GraysonKippes/stm32g071-devkit/kicad/stm32g0-devkit.kicad_pcb

## KiCad design kicad/stm32g0-devkit.kicad_pcb (2026-10-22)

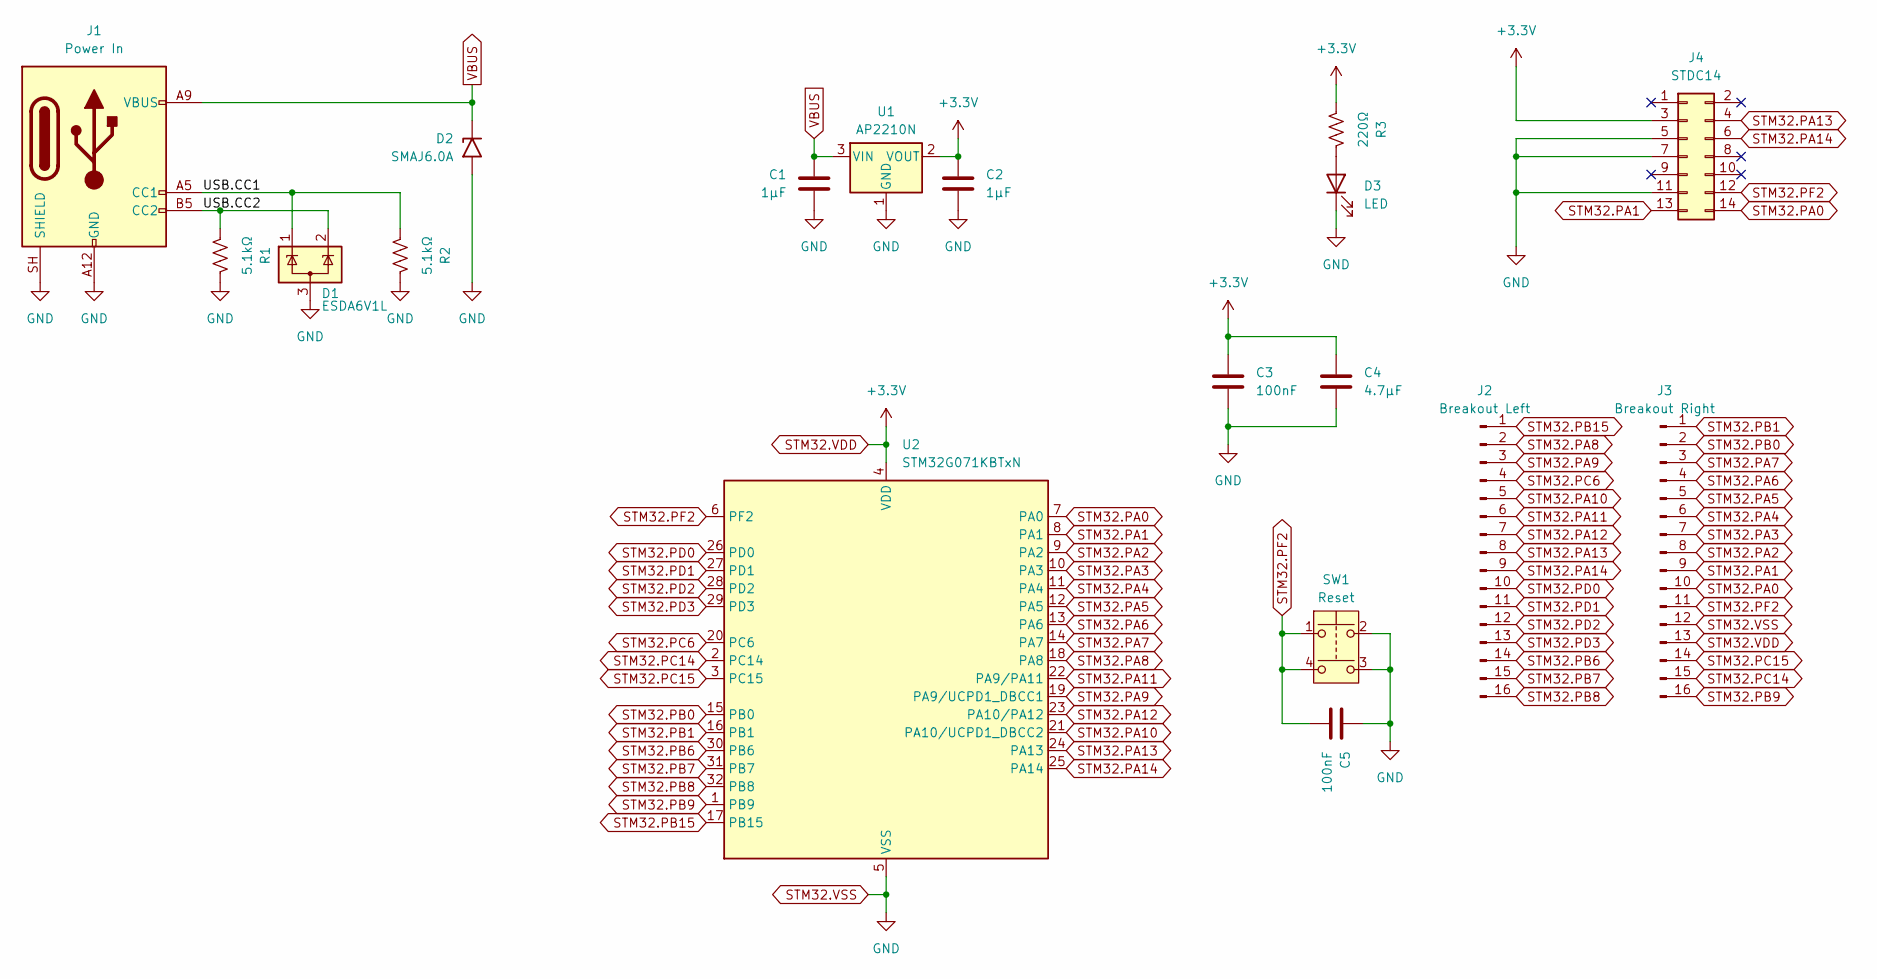
[picture p1: schematic stm32g0-devkit.kicad_sch]

Parts:
C1, C2: 1μF; C_0805_2012Metric_Pad1.18x1.45mm_HandSolder
C3, C5: 100nF; C_0805_2012Metric_Pad1.18x1.45mm_HandSolder
C4: 4.7μF; C_0805_2012Metric_Pad1.18x1.45mm_HandSolder
D1: ESDA6V1L; SOT-23
D2: SMAJ6.0A; D_SMA_Handsoldering
D3: LED; LED_0805_2012Metric_Pad1.15x1.40mm_HandSolder
J1: Power In; USB_C_Receptacle_GCT_USB4135-GF-A_6P_TopMnt_Horizontal
J2: Breakout Left; PinSocket_1x16_P2.54mm_Vertical
J3: Breakout Right; PinSocket_1x16_P2.54mm_Vertical
J4: STDC14; PinSocket_2x07_P1.27mm_Vertical
R1, R2: 5.1kΩ; R_0805_2012Metric_Pad1.20x1.40mm_HandSolder
R3: 220Ω; R_0805_2012Metric_Pad1.20x1.40mm_HandSolder
SW1: Reset; KMR221NG
U1: AP2210N; SOT-23-3
U2: STM32G071KBTxN; LQFP-32_7x7mm_P0.8mm

Connections:
/USB.CC1: D1.1 (K), J1.A5 (CC1), R2.1
/USB.CC2: D1.2 (K), J1.B5 (CC2), R1.1
unnamed: D3.2 (A), R3.2
STM32.PA0: J3.10, J4.14, U2.7 (PA0)
STM32.PA1: J3.9, J4.13, U2.8 (PA1)
STM32.PA2: J3.8, U2.9 (PA2)
STM32.PA3: J3.7, U2.10 (PA3)
STM32.PA4: J3.6, U2.11 (PA4)
STM32.PA5: J3.5, U2.12 (PA5)
STM32.PA6: J3.4, U2.13 (PA6)
STM32.PA7: J3.3, U2.14 (PA7)
STM32.PA8: J2.2, U2.18 (PA8)
STM32.PA9: J2.3, U2.19 (PA9/UCPD1_DBCC1)
STM32.PA10: J2.5, U2.21 (PA10/UCPD1_DBCC2)
STM32.PA11: J2.6, U2.22 (PA9/PA11)
STM32.PA12: J2.7, U2.23 (PA10/PA12)
STM32.PA13: J2.8, J4.4, U2.24 (PA13)
STM32.PA14: J2.9, J4.6, U2.25 (PA14)
STM32.PB0: J3.2, U2.15 (PB0)
STM32.PB1: J3.1, U2.16 (PB1)
STM32.PB6: J2.14, U2.30 (PB6)
STM32.PB7: J2.15, U2.31 (PB7)
STM32.PB8: J2.16, U2.32 (PB8)
STM32.PB9: J3.16, U2.1 (PB9)
STM32.PB15: J2.1, U2.17 (PB15)
STM32.PC6: J2.4, U2.20 (PC6)
STM32.PC14: J3.15, U2.2 (PC14)
STM32.PC15: J3.14, U2.3 (PC15)
STM32.PD0: J2.10, U2.26 (PD0)
STM32.PD1: J2.11, U2.27 (PD1)
STM32.PD2: J2.12, U2.28 (PD2)
STM32.PD3: J2.13, U2.29 (PD3)
STM32.PF2: C5.1, J3.11, J4.12, SW1.1, SW1.4, U2.6 (PF2)
STM32.VDD: C2.2, C3.2, C4.2, J3.13, J4.3, R3.1, U1.2 (VOUT), U2.4 (VDD)
STM32.VSS: C1.1, C2.1, C3.1, C4.1, C5.2, D1.3 (A), D2.2 (A2), D3.1 (K), J1.A12 (GND), J1.B12 (GND), J1.SH (SHIELD), J3.12, J4.5, J4.7, J4.11, R1.2, R2.2, SW1.2, SW1.3, U1.1 (GND), U2.5 (VSS)
VBUS: C1.2, D2.1 (A1), J1.A9 (VBUS), J1.B9 (VBUS), U1.3 (VIN)

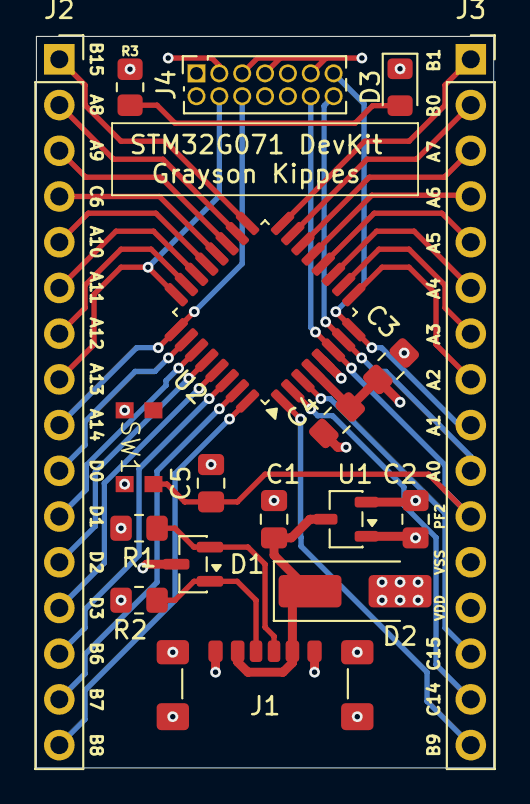
[picture p2: board stm32g0-devkit.kicad_pcb from above]

Board: 4 copper layers, 25.4 x 40.6 mm, 18 parts (0 on the bottom side), 36 nets.
